G-Pereira/tigard/tigard.kicad_pcb

## KiCad design tigard.kicad_pcb (2021-05-15)

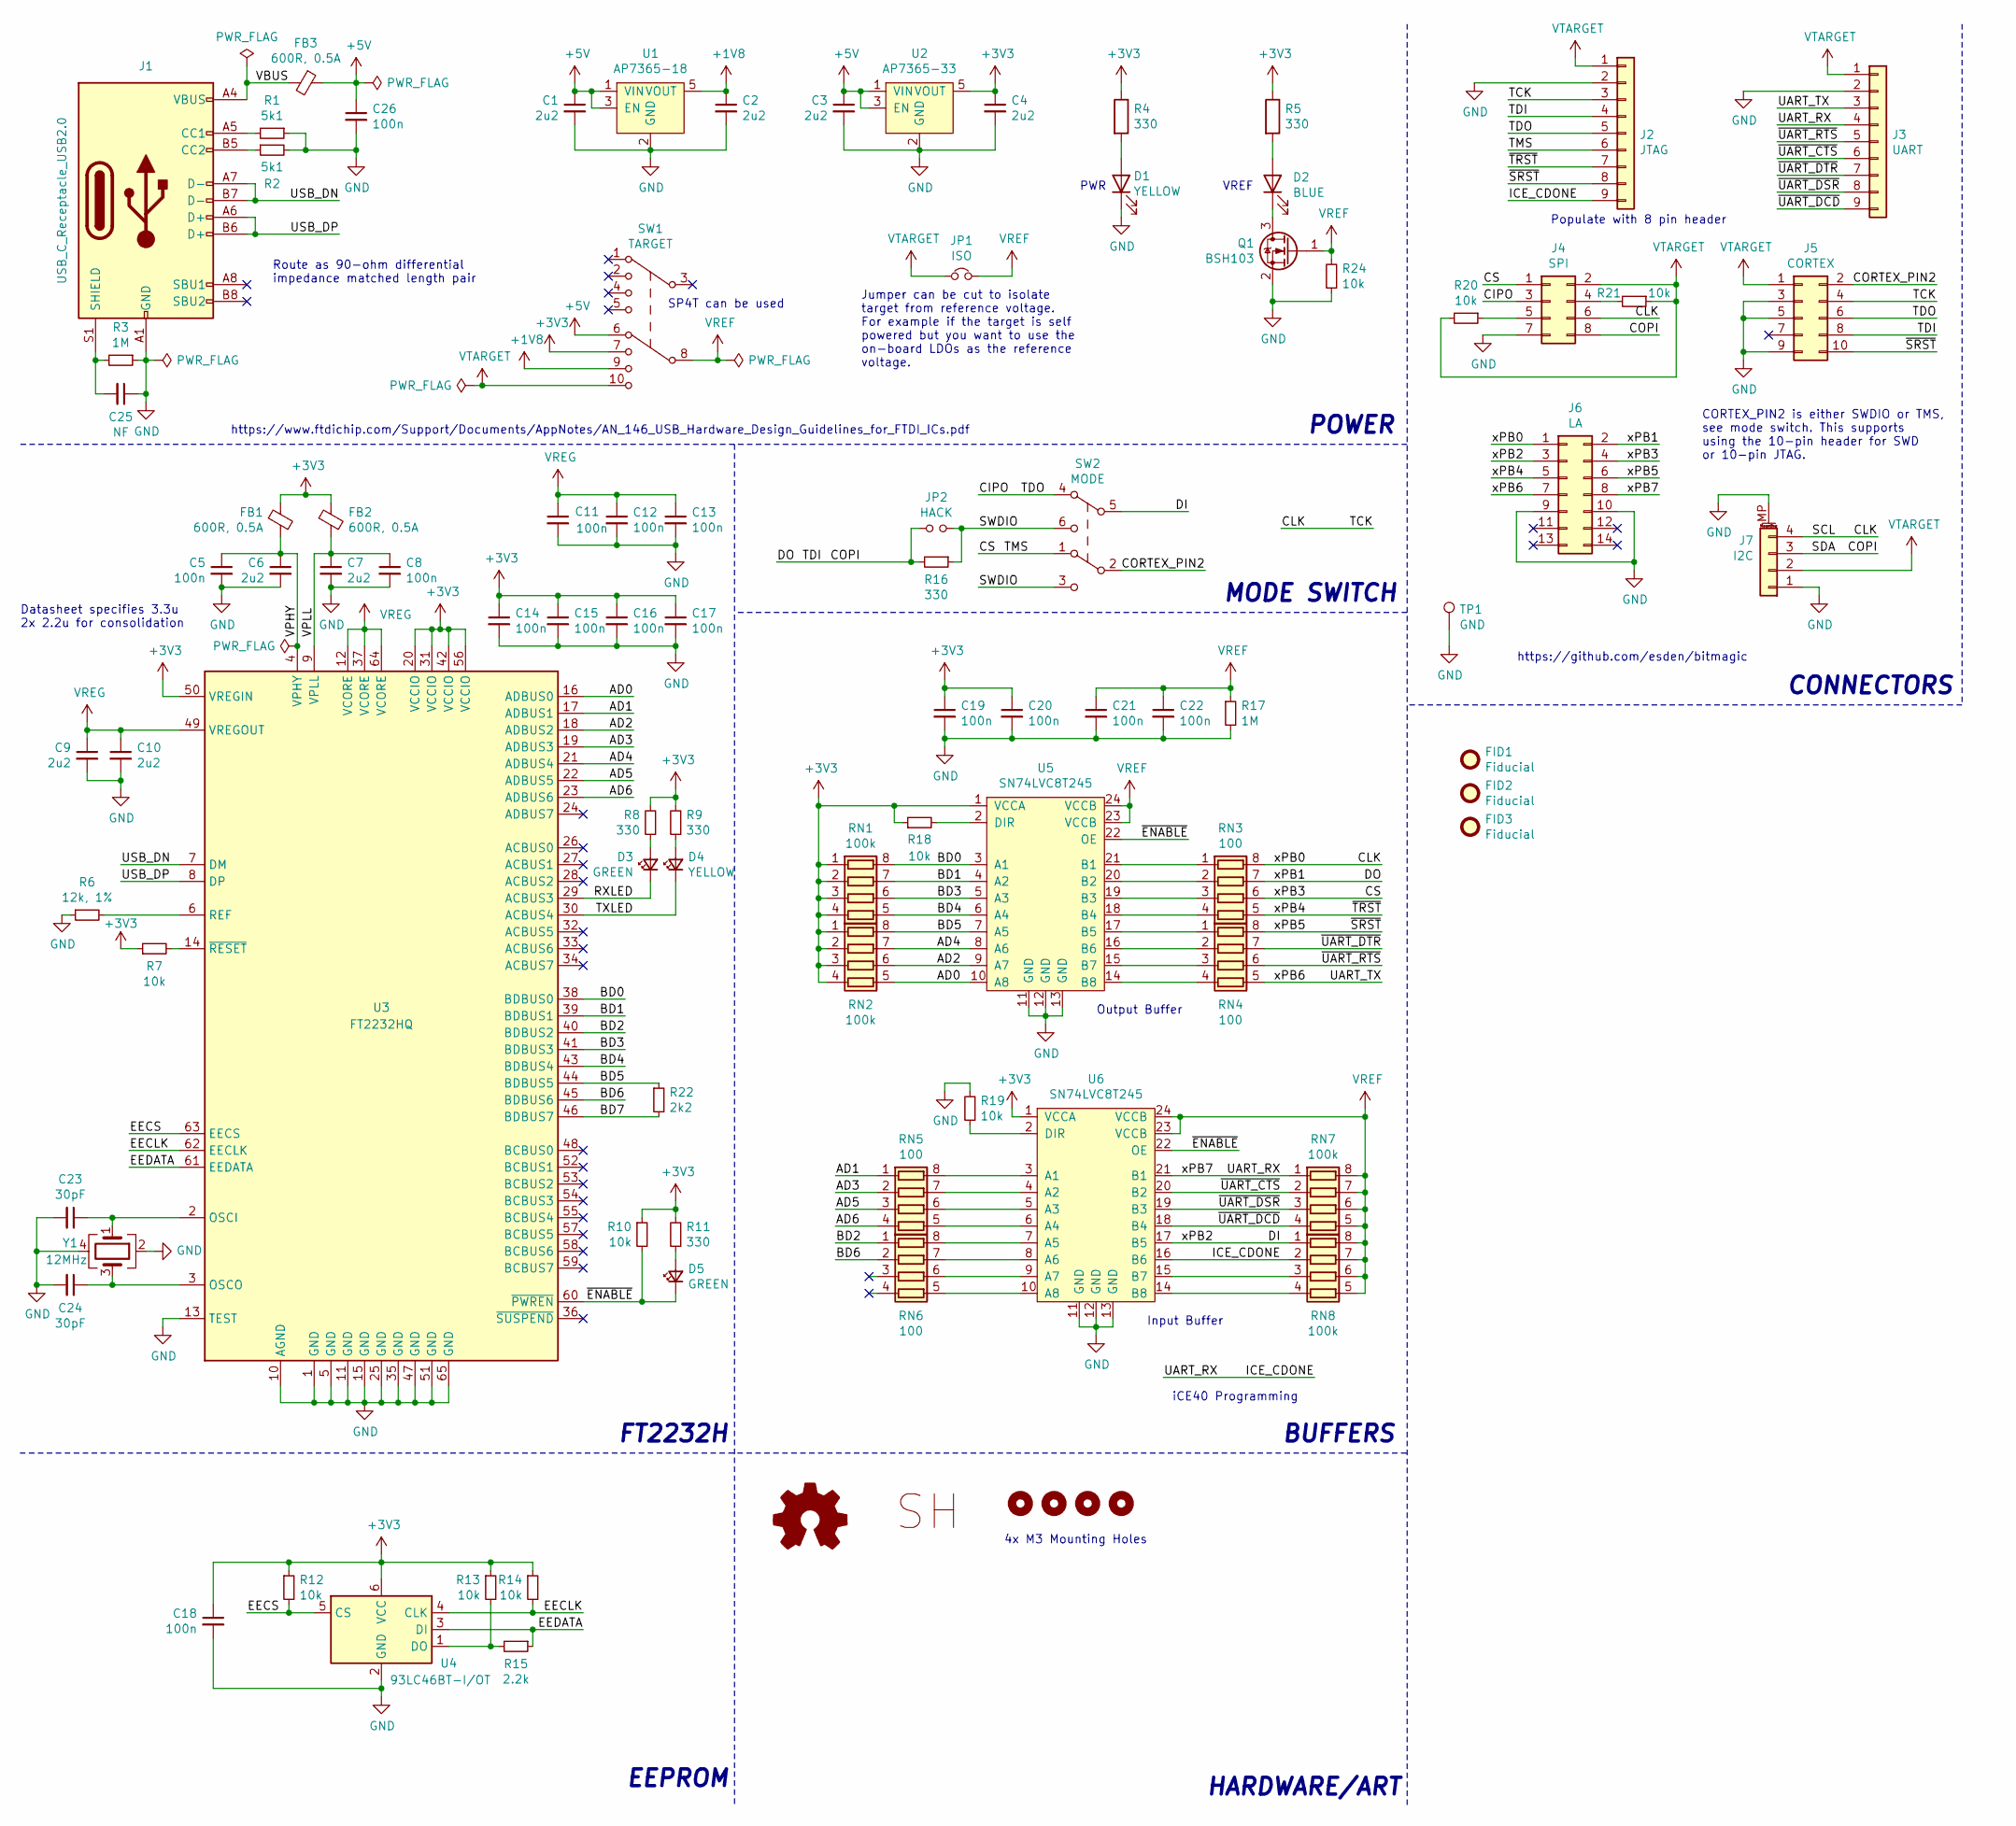
[picture p1: schematic tigard.sch]

Parts:
C1, C2, C3, C4, C6, C7, C9, C10: 2u2; C_0402_1005Metric; LCSC C307419
C5, C8, C11, C12, C13, C14, C15, C16, C17, C18, C19, C20, C21, C22, C26: 100n; C_0402_1005Metric; LCSC C100072
C23, C24: 30pF; C_0402_1005Metric; LCSC C159804
C25: NF; C_0402_1005Metric
D1, D4: YELLOW; LED_0603_1608Metric; LCSC C160477
D2: BLUE; LED_0603_1608Metric; LCSC C157738
D3, D5: GREEN; LED_0603_1608Metric; LCSC C12065
FB1, FB2, FB3: 600R, 0.5A; L_0402_1005Metric; LCSC C76886
FID1, FID2, FID3: Fiducial; Fiducial_0.5mm_Mask1mm
H1, H2, H3, H4: MountingHole; MountingHole_3.2mm_M3_ISO7380
J1: USB_C_Receptacle_USB2.0; USB_C_Receptacle_HRO_TYPE-C-31-M-12; LCSC C165948
J2: JTAG; PinHeader_1x09_P2.54mm_Vertical; LCSC C358689
J3: UART; PinHeader_1x09_P2.54mm_Vertical; LCSC C492408
J4: SPI; PinHeader_2x04_P2.54mm_Vertical; LCSC C358693
J5: CORTEX; PinHeader_2x05_P1.27mm_Vertical_SMD; LCSC C448647
J6: LA; PinHeader_2x07_P1.27mm_Vertical_SMD
J7: I2C; JST_SH_SM04B-SRSS-TB_1x04-1MP_P1.00mm_Horizontal; LCSC C160404
JP1: ISO; SolderJumper-2_P1.3mm_Bridged_RoundedPad1.0x1.5mm
JP2: HACK; SolderJumper-2_P1.3mm_Open_RoundedPad1.0x1.5mm
LOGO1: Logo_Open_Hardware_Small; OSHW-Symbol_4.4x4mm_SilkScreen
LOGO2: Logo_SH; Securing_Hardware_Logo
Q1: BSH103; SOT-23_RoundRect; LCSC C88711
R1, R2: 5k1; R_0402_1005Metric; LCSC C25941
R3, R17: 1M; R_0402_1005Metric; LCSC C26087
R4, R5, R8, R9, R11, R16: 330; R_0402_1005Metric; LCSC C25104
R6: 12k, 1%; R_0402_1005Metric; LCSC C25752
R7, R10, R12, R13, R14, R18, R19, R20, R21, R24: 10k; R_0402_1005Metric; LCSC C301923
R15: 2.2k; R_0402_1005Metric; LCSC C25879
R22: 2k2; R_0402_1005Metric; LCSC C25933
RN1, RN2, RN7, RN8: 100k; R_Array_Convex_4x0402_RoundRect; LCSC C25724
RN3, RN4, RN5, RN6: 100; R_Array_Convex_4x0402_RoundRect; LCSC C48442
SW1: TARGET; SW_ALPS_SSSS224100_DP4T; LCSC C255514
SW2: MODE; SW_CuK_JS202011CQN_DPDT_Straight; LCSC C221663
TP1: GND; TestPoint_Keystone_5000-5004_Miniature; LCSC C238122
U1: AP7365-18; SOT-23-5_RoundRect; LCSC C460402
U2: AP7365-33; SOT-23-5_RoundRect; LCSC C150742
U3: FT2232HQ; QFN-64-1EP_9x9mm_P0.5mm_EP4.35x4.35mm_ThermalVias; LCSC C193662
U4: 93LC46BT-I/OT; SOT-23-6_RoundRect; LCSC C190271
U5, U6: SN74LVC8T245; TSSOP-24_4.4x7.8mm_P0.65mm; LCSC C27643
Y1: 12MHz; Crystal_SMD_3225-4Pin_3.2x2.5mm_RoundRect; LCSC C9002

Connections:
+1V8: C2.1, SW1.9, U1.5 (VOUT)
+3V3: C4.1, C14.1, C15.1, C16.1, C17.1, C18.1, C19.1, C20.1, FB1.1, FB2.1, R4.1, R5.1, R7.1, R8.2, R9.2, R10.1, R11.2, R12.1, R13.1, R14.1, R18.1, RN1.1 (R1.1), RN1.2 (R2.1), RN1.3 (R3.1), RN1.4 (R4.1), RN2.1 (R1.1), RN2.2 (R2.1), RN2.3 (R3.1), RN2.4 (R4.1), SW1.7, U2.5 (VOUT), U3.20 (VCCIO), U3.31 (VCCIO), U3.42 (VCCIO), U3.50 (VREGIN), U3.56 (VCCIO), U4.6 (VCC), U5.1 (VCCA), U6.1 (VCCA)
+5V: C1.1, C3.1, C26.1, FB3.1, SW1.6, U1.1 (VIN), U1.3 (EN), U2.1 (VIN), U2.3 (EN)
/AD0: RN2.5 (R4.2), U3.16 (ADBUS0), U5.10 (A8)
/AD1: RN5.1 (R1.1), U3.17 (ADBUS1)
/AD2: RN2.6 (R3.2), U3.18 (ADBUS2), U5.9 (A7)
/AD3: RN5.2 (R2.1), U3.19 (ADBUS3)
/AD4: RN2.7 (R2.2), U3.21 (ADBUS4), U5.8 (A6)
/AD5: RN5.3 (R3.1), U3.22 (ADBUS5)
/AD6: RN5.4 (R4.1), U3.23 (ADBUS6)
/BD0: RN1.8 (R1.2), U3.38 (BDBUS0), U5.3 (A1)
/BD1: RN1.7 (R2.2), U3.39 (BDBUS1), U5.4 (A2)
/BD2: RN6.1 (R1.1), U3.40 (BDBUS2)
/BD3: RN1.6 (R3.2), U3.41 (BDBUS3), U5.5 (A3)
/BD4: RN1.5 (R4.2), U3.43 (BDBUS4), U5.6 (A4)
/BD5: R22.1, RN2.8 (R1.2), U3.44 (BDBUS5), U5.7 (A5)
/BD6: RN6.2 (R2.1), U3.45 (BDBUS6)
/BD7: R22.2, U3.46 (BDBUS7)
/CIPO: J2.5, J4.3, J5.6, SW2.4
/CLK: J2.3, J4.6, J5.4, J6.1, J7.4, RN3.8 (R1.2)
/COPI: J2.4, J4.8, J5.8, J6.2, J7.3, JP2.1, R16.2, RN3.7 (R2.2)
/CORTEX_PIN2: J5.2, SW2.2
/CS: J2.6, J4.1, J6.4, RN3.6 (R3.2), SW2.1
/DI: J6.3, RN8.1 (R1.1), SW2.5, U6.17 (B5)
/EECLK: R14.2, U3.62 (EECLK), U4.4 (CLK)
/EECS: R12.2, U3.63 (EECS), U4.5 (CS)
/EEDATA: R15.1, U3.61 (EEDATA), U4.3 (DI)
/ICE_CDONE: J2.9, J3.4, J6.8, RN7.1 (R1.1), RN8.2 (R2.1), U6.16 (B6), U6.21 (B1)
/RXLED: D3.1 (K), U3.29 (ACBUS3)
/SWDIO: JP2.2, R16.1, SW2.3, SW2.6
/TXLED: D4.1 (K), U3.30 (ACBUS4)
/UART_TX: J3.3, J6.7, RN4.5 (R4.2)
/USB_DN: J1.A7 (D-), J1.B7 (D-), U3.7 (DM)
/USB_DP: J1.A6 (D+), J1.B6 (D+), U3.8 (DP)
/VBUS: FB3.2, J1.A4 (VBUS), J1.A9 (VBUS), J1.B4 (VBUS), J1.B9 (VBUS)
/VPHY: C5.1, C6.1, FB1.2, U3.4 (VPHY)
/VPLL: C7.1, C8.1, FB2.2, U3.9 (VPLL)
/xPB4: J2.7, J6.5, RN3.5 (R4.2)
/xPB5: J2.8, J5.10, J6.6, RN4.8 (R1.2)
/~ENABLE: D5.1 (K), R10.2, U3.60 (~PWREN), U5.22 (OE), U6.22 (OE)
/~UART_CTS: J3.6, RN7.2 (R2.1), U6.20 (B2)
/~UART_DCD: J3.9, RN7.4 (R4.1), U6.18 (B4)
/~UART_DSR: J3.8, RN7.3 (R3.1), U6.19 (B3)
/~UART_DTR: J3.7, RN4.7 (R2.2)
/~UART_RTS: J3.5, RN4.6 (R3.2)
GND: C1.2, C2.2, C3.2, C4.2, C5.2, C6.2, C7.2, C8.2, C9.2, C10.2, C11.2, C12.2, C13.2, C14.2, C15.2, C16.2, C17.2, C18.2, C19.2, C20.2, C21.2, C22.2, C23.2, C24.2, C25.1, C26.2, D1.1 (K), J1.A1 (GND), J1.A12 (GND), J1.B1 (GND), J1.B12 (GND), J2.2, J3.2, J4.7, J5.3, J5.5, J5.9, J6.9, J6.10, J7.1, J7.MP (MountPin), Q1.2 (S), R1.1, R2.2, R3.1, R6.1, R17.2, R19.2, R24.1, TP1.1, U1.2 (GND), U2.2 (GND), U3.1 (GND), U3.5 (GND), U3.10 (AGND), U3.11 (GND), U3.13 (TEST), U3.15 (GND), U3.25 (GND), U3.35 (GND), U3.47 (GND), U3.51 (GND), U3.65 (GND), U4.2 (GND), U5.11 (GND), U5.12 (GND), U5.13 (GND), U6.11 (GND), U6.12 (GND), U6.13 (GND), Y1.2, Y1.4
unnamed: C23.1, U3.2 (OSCI), Y1.1
unnamed: C24.1, U3.3 (OSCO), Y1.3
unnamed: C25.2, J1.S1 (SHIELD), R3.2
unnamed: D1.2 (A), R4.2
unnamed: D2.1 (K), Q1.3 (D)
unnamed: D2.2 (A), R5.2
unnamed: D3.2 (A), R8.1
unnamed: D4.2 (A), R9.1
unnamed: D5.2 (A), R11.1
unnamed: J1.A5 (CC1), R1.2
unnamed: J1.B5 (CC2), R2.1
unnamed: J4.4, R21.2
unnamed: J4.5, R20.1
unnamed: R6.2, U3.6 (REF)
unnamed: R7.2, U3.14 (~RESET)
unnamed: R13.2, R15.2, U4.1 (DO)
unnamed: R18.2, U5.2 (DIR)
unnamed: R19.1, U6.2 (DIR)
unnamed: RN3.1 (R1.1), U5.21 (B1)
unnamed: RN3.2 (R2.1), U5.20 (B2)
unnamed: RN3.3 (R3.1), U5.19 (B3)
unnamed: RN3.4 (R4.1), U5.18 (B4)
unnamed: RN4.1 (R1.1), U5.17 (B5)
unnamed: RN4.2 (R2.1), U5.16 (B6)
unnamed: RN4.3 (R3.1), U5.15 (B7)
unnamed: RN4.4 (R4.1), U5.14 (B8)
unnamed: RN5.5 (R4.2), U6.6 (A4)
unnamed: RN5.6 (R3.2), U6.5 (A3)
unnamed: RN5.7 (R2.2), U6.4 (A2)
unnamed: RN5.8 (R1.2), U6.3 (A1)
unnamed: RN6.5 (R4.2), U6.10 (A8)
unnamed: RN6.6 (R3.2), U6.9 (A7)
unnamed: RN6.7 (R2.2), U6.8 (A6)
unnamed: RN6.8 (R1.2), U6.7 (A5)
unnamed: RN8.3 (R3.1), U6.15 (B7)
unnamed: RN8.4 (R4.1), U6.14 (B8)
VREF: C21.1, C22.1, JP1.2, Q1.1 (G), R17.1, R24.2, RN7.5 (R4.2), RN7.6 (R3.2), RN7.7 (R2.2), RN7.8 (R1.2), RN8.5 (R4.2), RN8.6 (R3.2), RN8.7 (R2.2), RN8.8 (R1.2), SW1.8, U5.23 (VCCB), U5.24 (VCCB), U6.23 (VCCB), U6.24 (VCCB)
VREG: C9.1, C10.1, C11.1, C12.1, C13.1, U3.12 (VCORE), U3.37 (VCORE), U3.49 (VREGOUT), U3.64 (VCORE)
VTARGET: J2.1, J3.1, J4.2, J5.1, J7.2, JP1.1, R20.2, R21.1, SW1.10

Notes on the sheet:
PWR
POWER
VREF
CONNECTORS
FT2232H
EEPROM
Output Buffer
Input Buffer
BUFFERS
MODE SWITCH
Datasheet specifies 3.3u 2x 2.2u for consolidation
HARDWARE/ART
4x M3 Mounting Holes
https://www.ftdichip.com/Support/Documents/AppNotes/AN_146_USB_Hardware_Design_Guidelines_for_FTDI_ICs.pdf
Route as 90-ohm differential impedance matched length pair
SP4T can be used
Jumper can be cut to isolate target from reference voltage. For example if the target is self powered but you want to use the on-board LDOs as the reference voltage.
CORTEX_PIN2 is either SWDIO or TMS, see mode switch. This supports using the 10-pin header for SWD or 10-pin JTAG.
https://github.com/esden/bitmagic
iCE40 Programming
Populate with 8 pin header

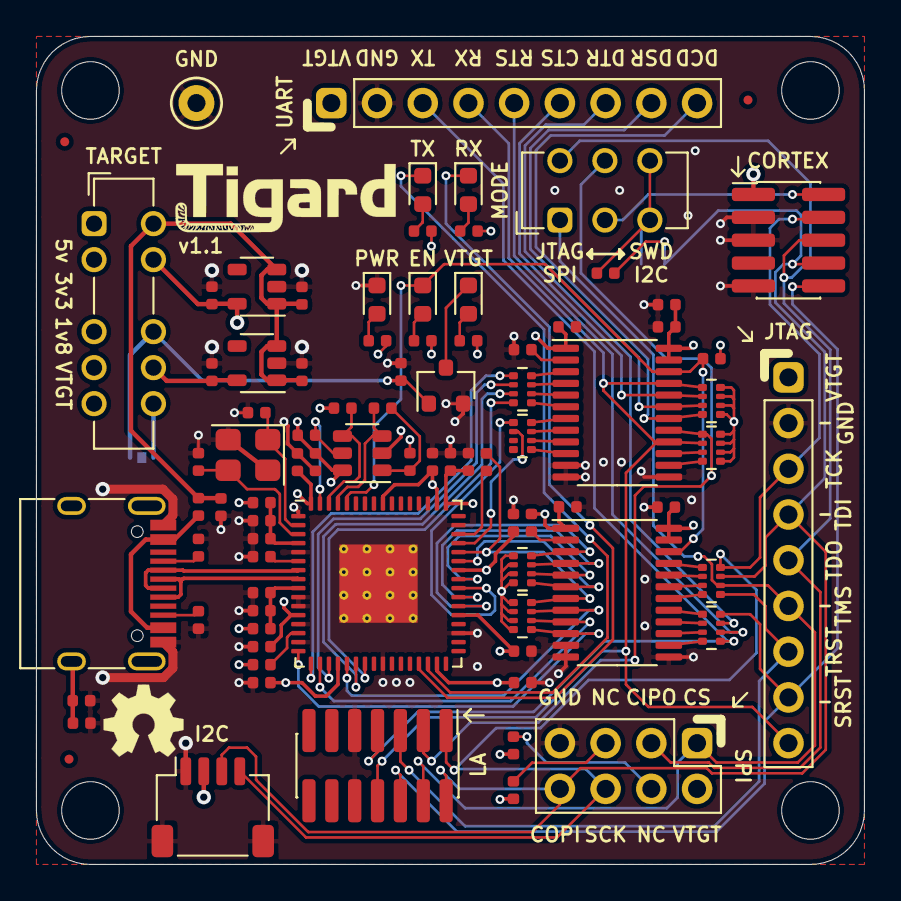
[picture p2: board tigard.kicad_pcb from above]

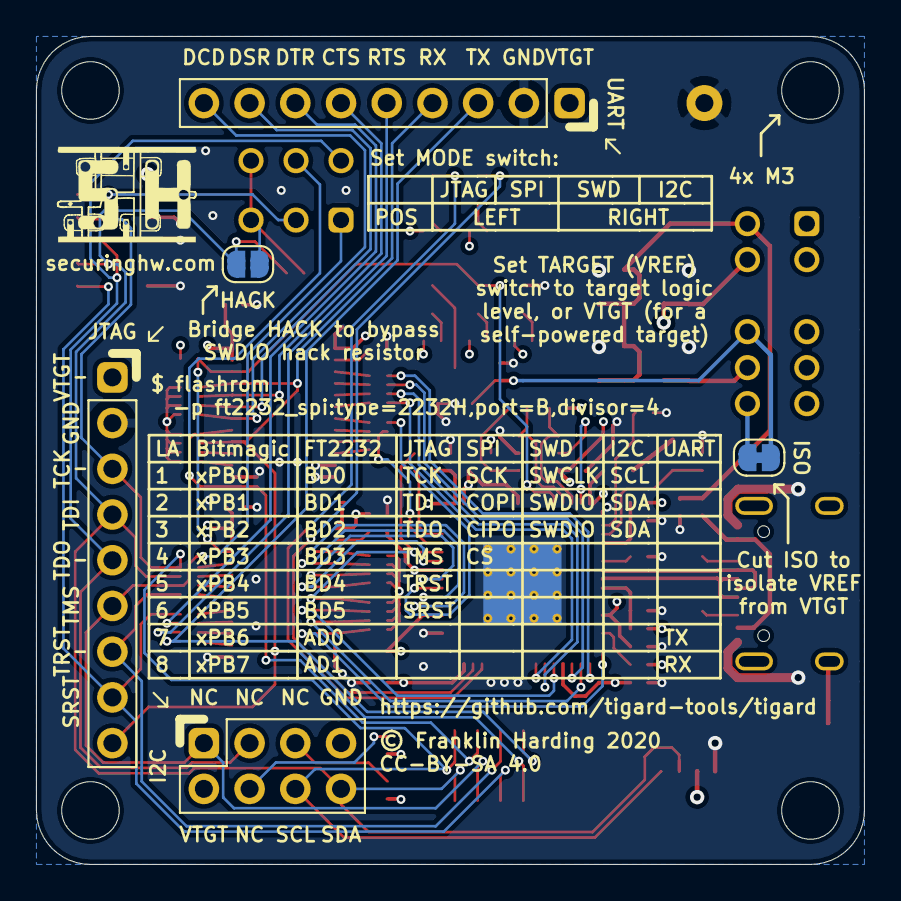
[picture p3: board tigard.kicad_pcb from below]

Board: 4 copper layers, 46.0 x 46.0 mm, 94 parts (3 on the bottom side), 85 nets.
