G-Pereira/tigard/(commit log)

2021-05-15 Add fidutials
    [tigard.kicad_pcb, tigard.sch]
2021-05-15 Set soldermask clerance to zero
    [tigard.kicad_pcb]
