G-Pereira/tigard/(notices)

Notices in the files:
tigard.kicad_pcb:
Copyright Franklin Harding 2020
Licensed under CC-BY-SA 4.0
© Franklin Harding 2020
CC-BY-SA 4.0
tigard.sch:
Copyright 2020 Franklin Harding
